vad7/BMS2/DC-DC 10-110V - 5V.png

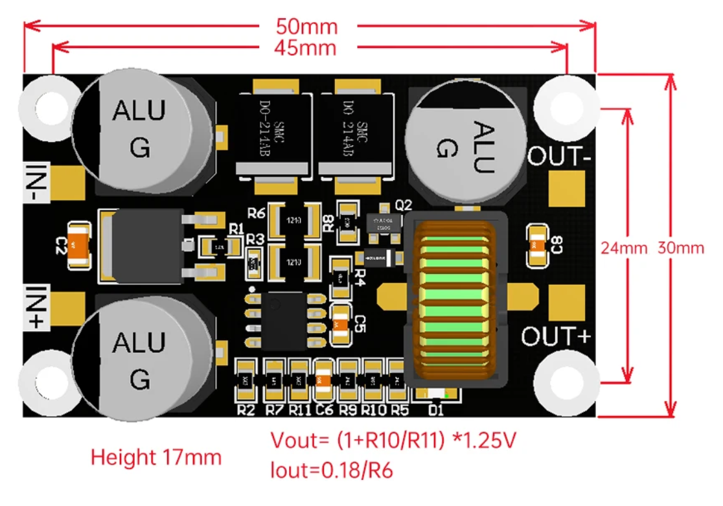
DC-DC 10-110V - 5V.png
