vad7/BMS2/arduino-nano-v3-328pb-pinout.png

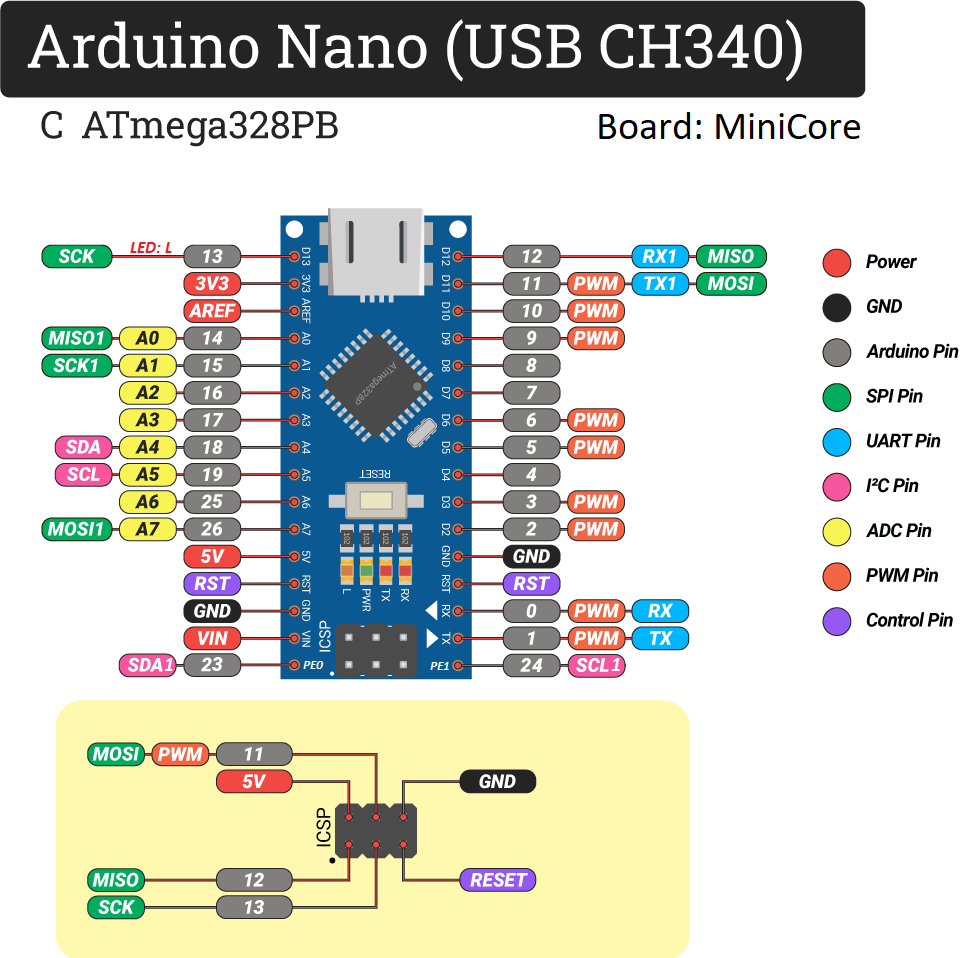
arduino-nano-v3-328pb-pinout.png
