vad7/BMS2/Schematic_BMS2.pdf

## LCD 2004

## External device

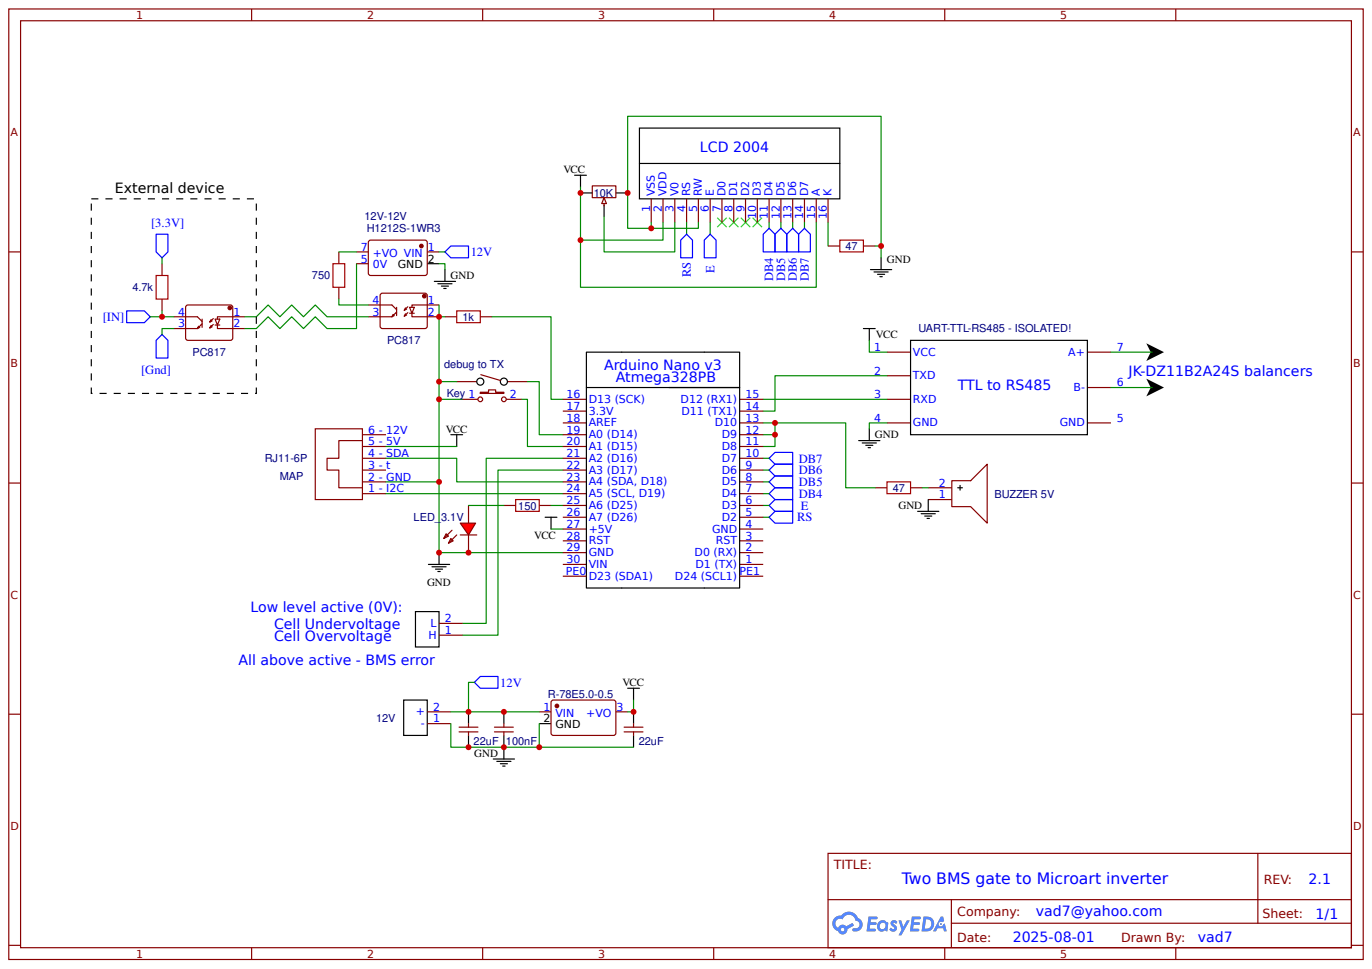
[picture p3: page 1]

Low level active (0V):
Cell Undervoltage
Cell Оvervoltage
All above active - BMS error
