vad7/BMS2/(commit log)

2025-09-03 upd (max 3 BMS)
2025-09-05 + schematic
2025-11-13 Вывод ошибки на пин в виде серии импульсов
2025-12-13 info: LED / on LCD
2025-12-24 софтовый UART(333Гц) для информирования (ошибки, мин/макс ячейки, напряжение АКБ)
2026-01-05 fix BMS protocol doc
    [BMS2.ino]
2026-01-07 изменение количества BMS по длительному нажатию кнопки, далее короткими, отображение процедуры на LCD
